nlshipp/openjtag-project/OpenJTAG/Docs/OPENJTAG Hardware User Manual_1.1.pdf

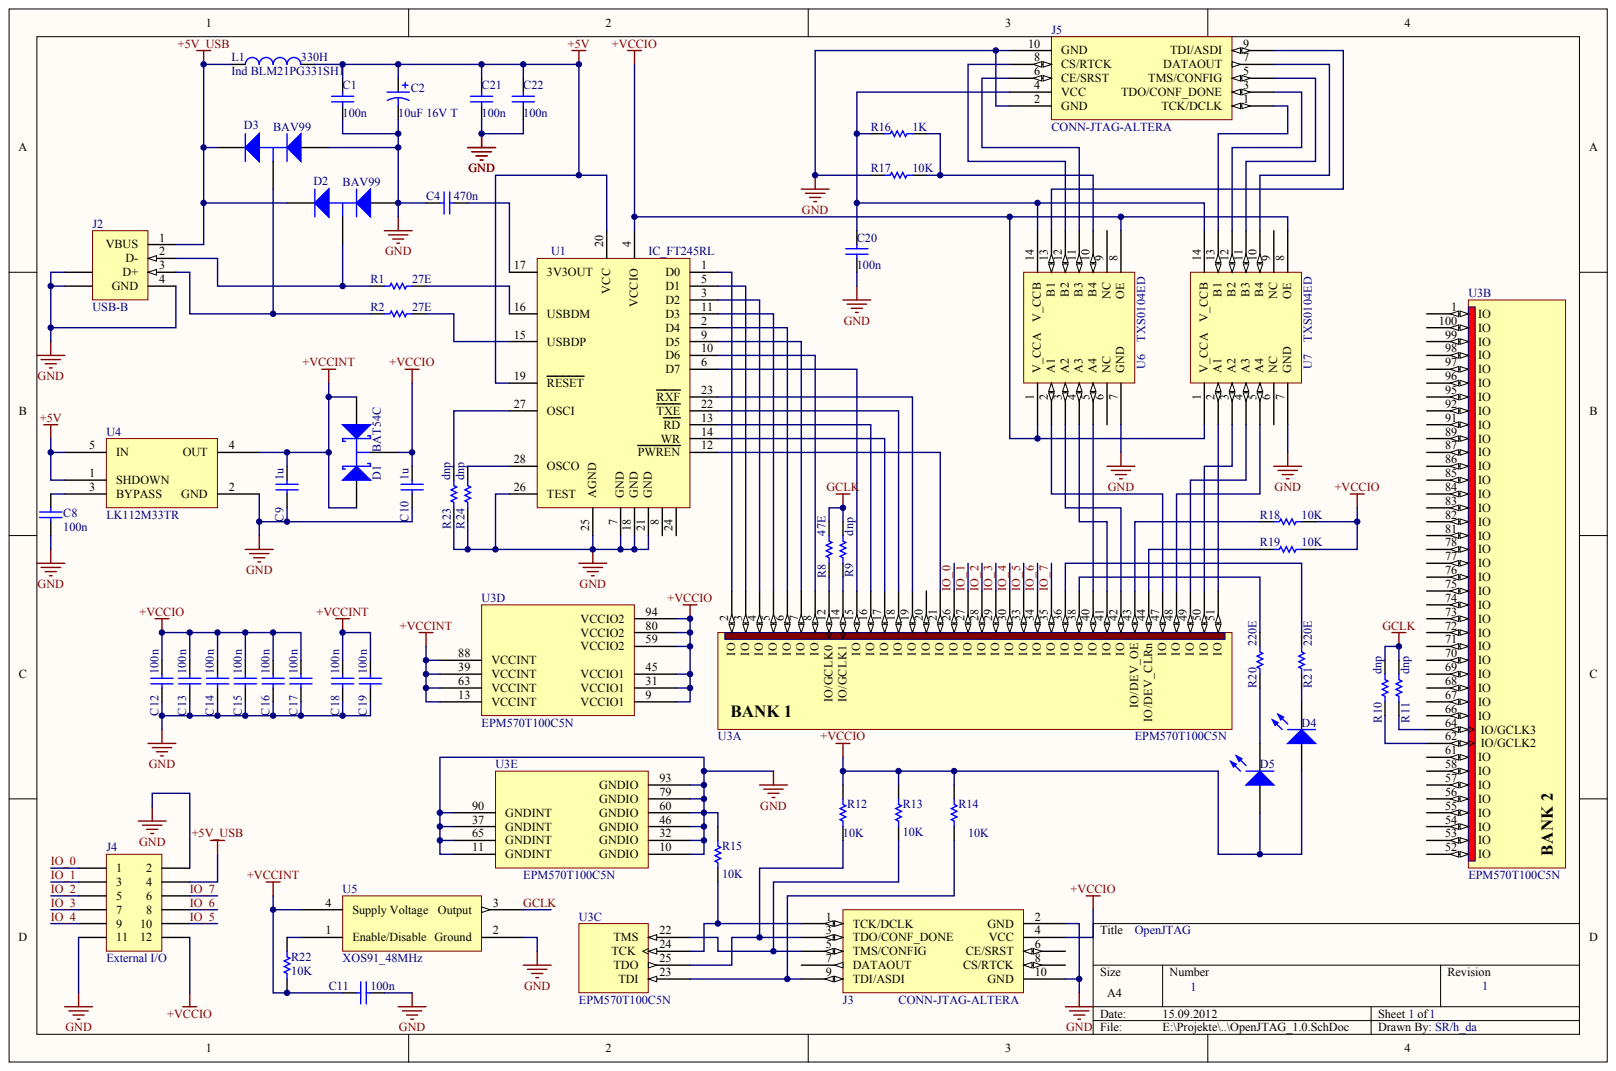
[picture p1: page 1]

GNDIO | 10 GNDINT 11 32 GNDIO 46 GNDIO 60

GNDINT 65
