nlshipp/openjtag-project/OpenJTAG/Docs/AK-OPENJTAG_V2.0.pdf

FPGA-POWER/CLOCK/JTAG | EXTERNAL JTAG/ETM CONNECTOR
20 B1 | 18 B2 | 17 B3 | 16 B4 | 15 B5 | 14 B6 | 13 B7 | 12 B8

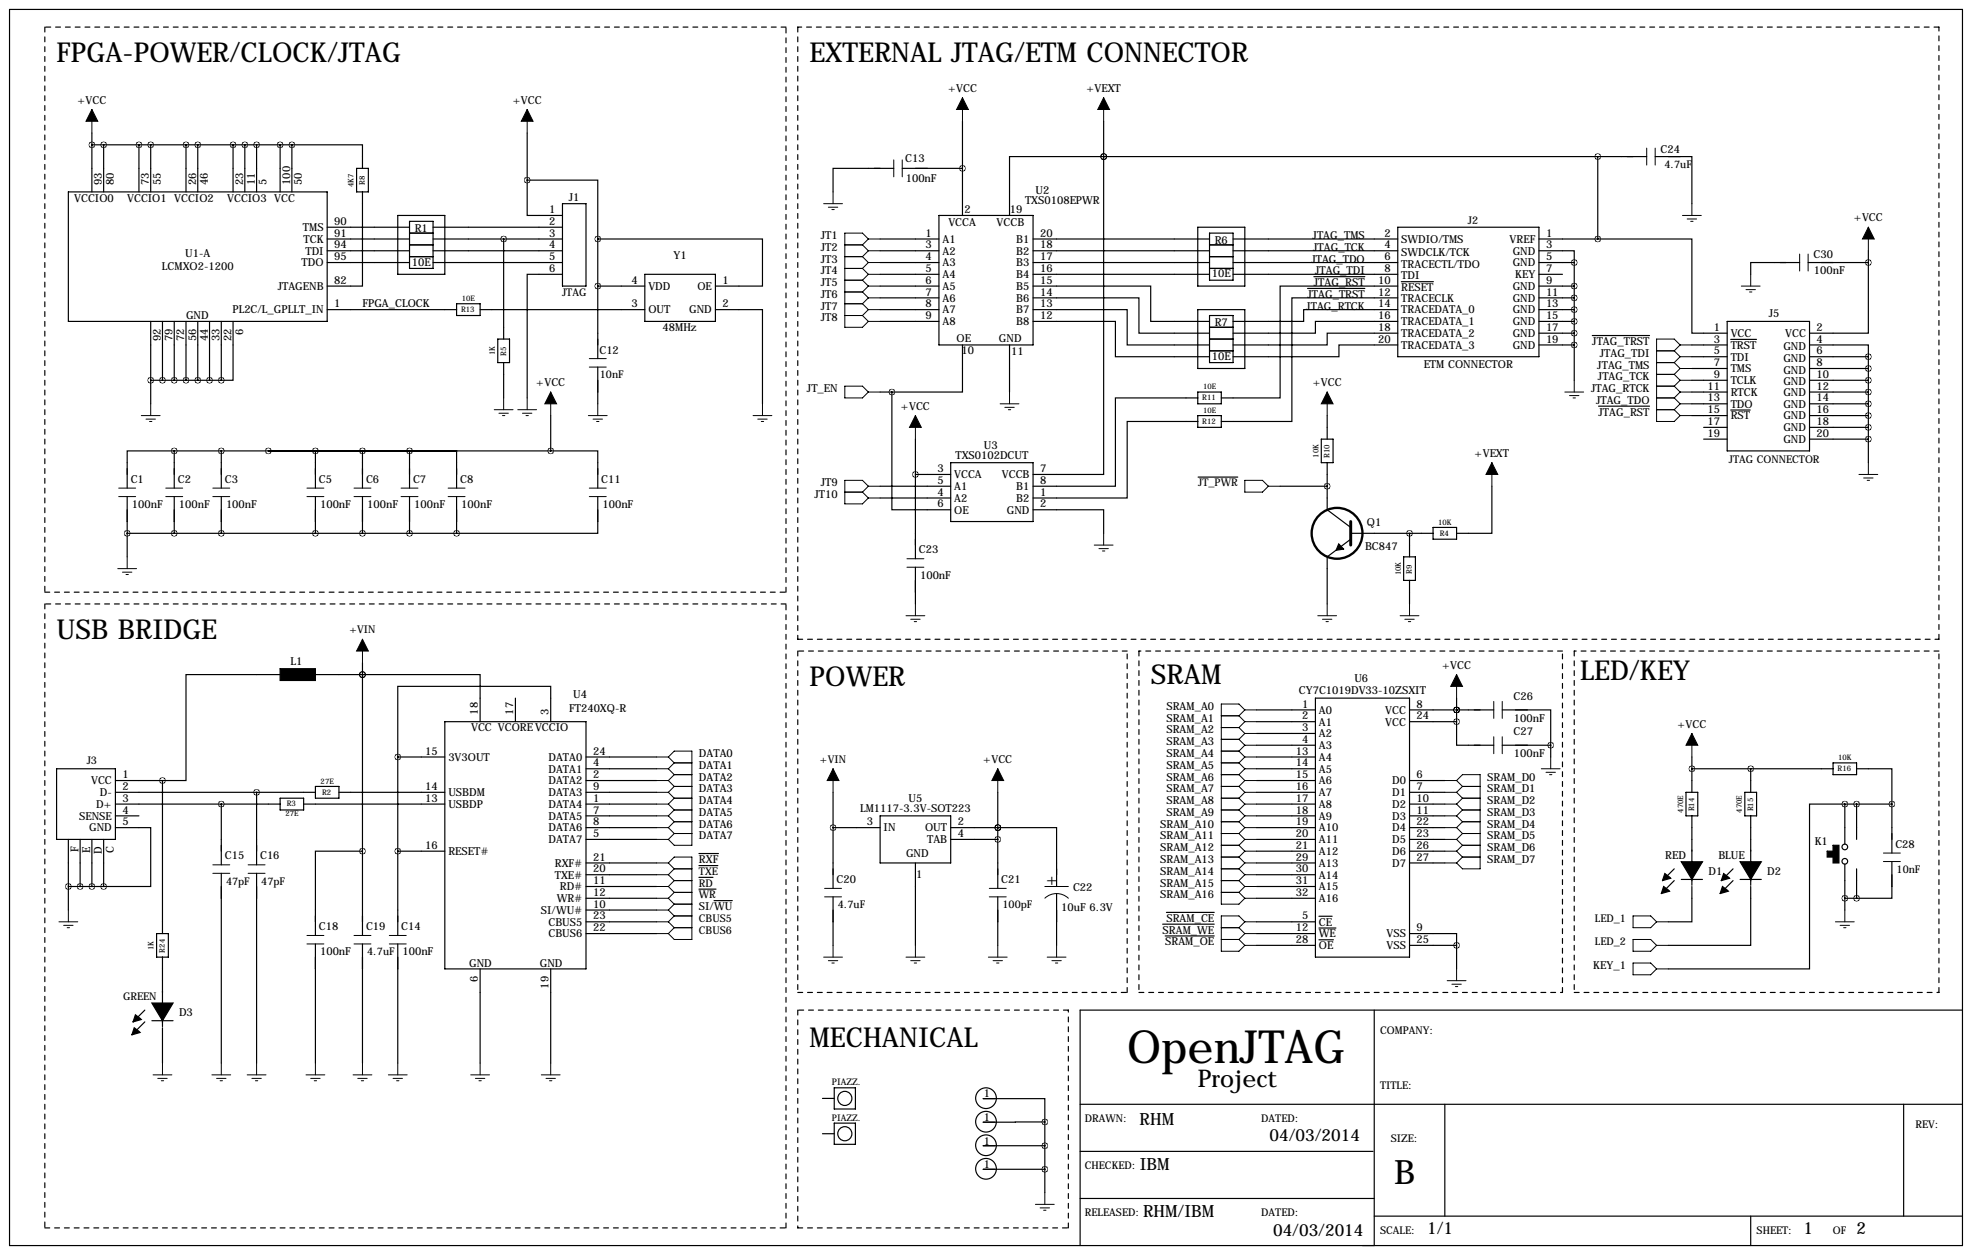
[picture p2: page 1]

# FLASH MEMORY FPGA

51 PR10D | 52 PR10C | 53 PR9D | 54 PR9C | 57 PR9B | 58 PR9A | 59 PR8D | 60 PR8C | 61 PR8A | 62 PR5D/PCLKC1_0 | 63 PR5C/PCLKT1_0 | 64 PR5B | 65 PR5A | 66 PR4D | 67 PR4C | 68 PR4B | 69 PR4A | 70 PR3B | 71 PR3A | 74 PR2B | 75 PR2A

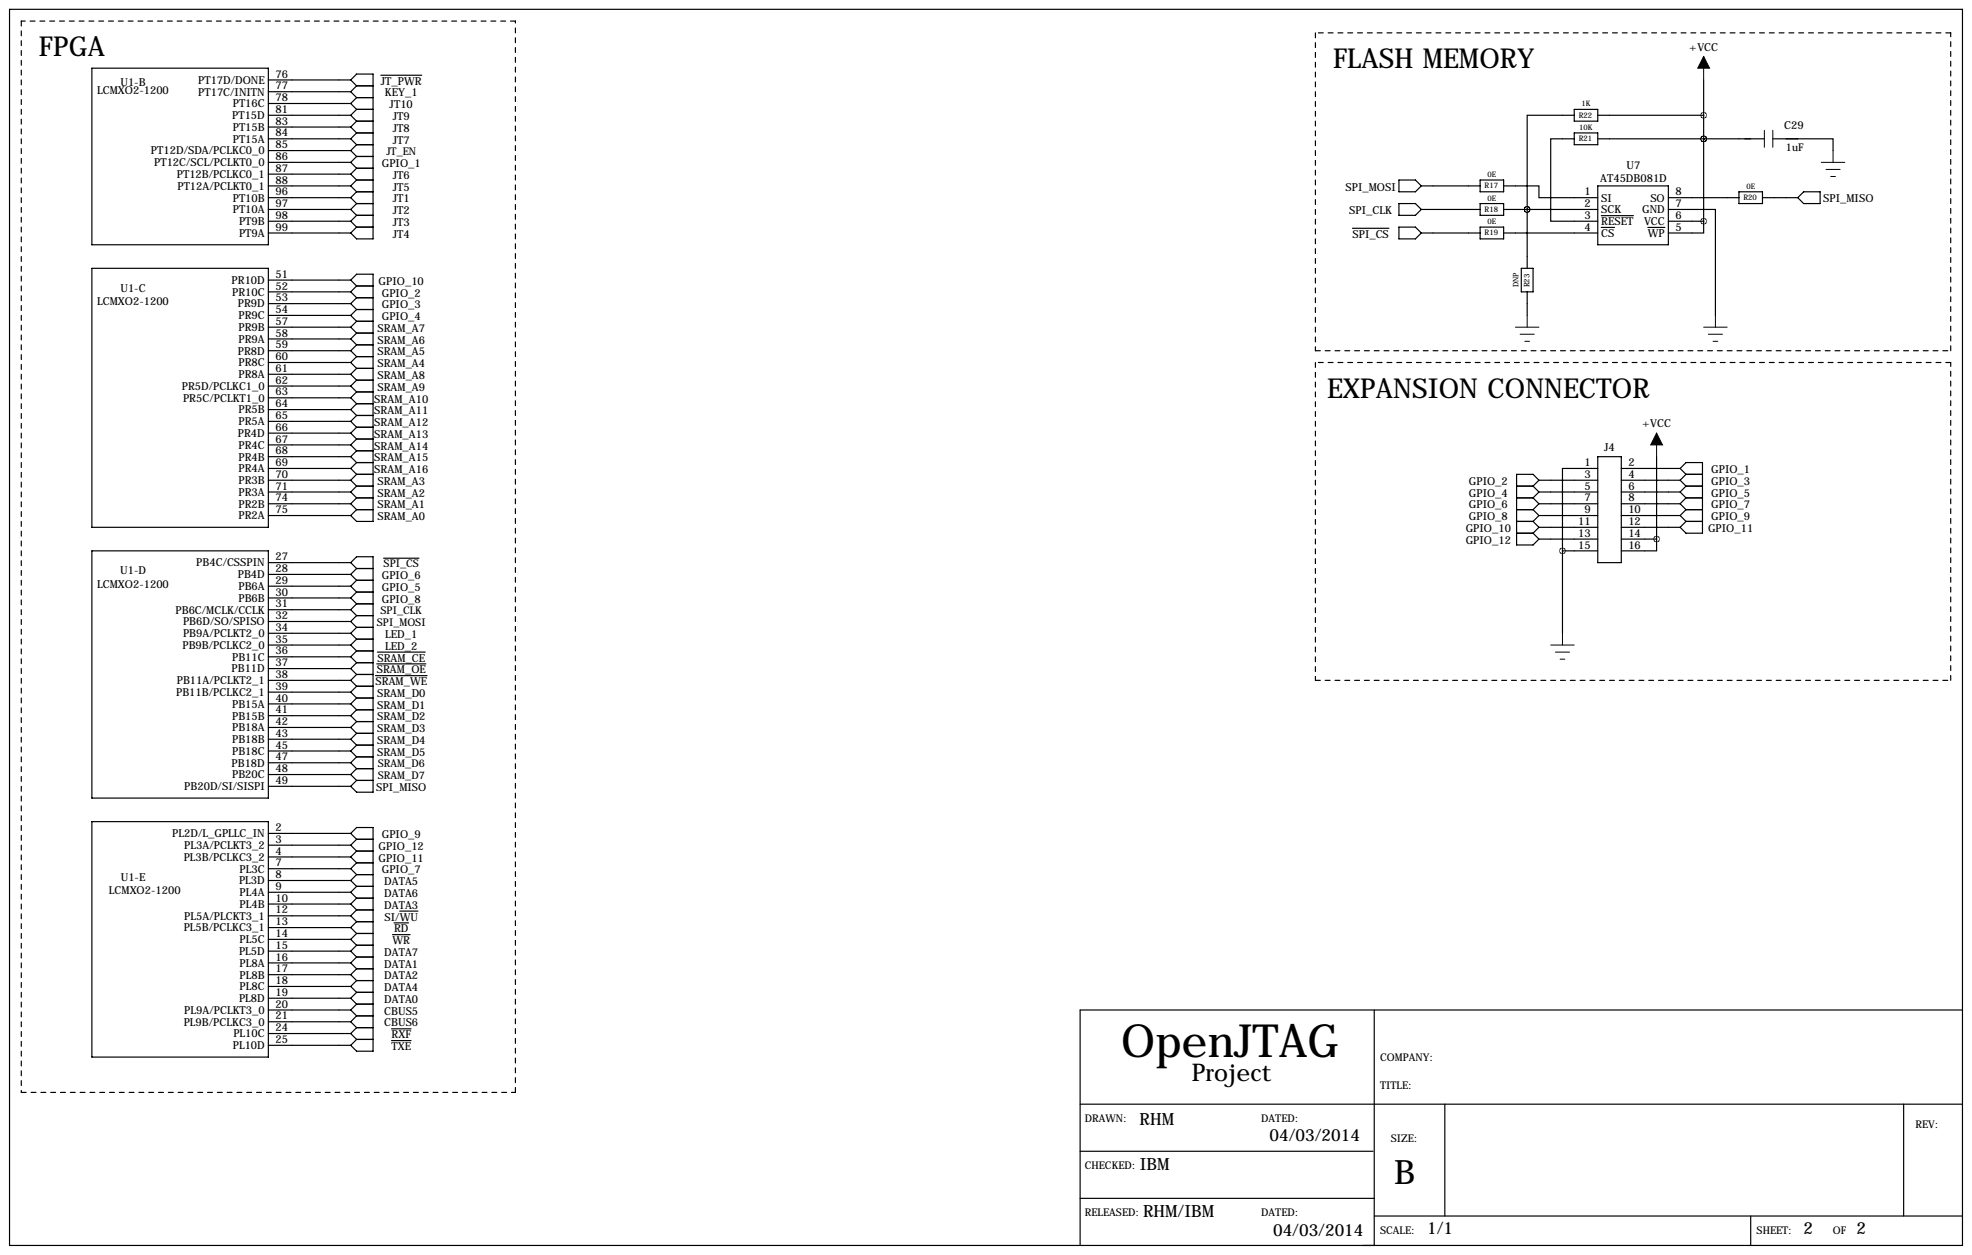
[picture p3: page 2]

EXPANSION CONNECTOR +VCC
