nlshipp/openjtag-project/(commit log)

2026-03-17 Add OpenJTAG2 board schematic
    Archive OpenJTAG2 board schematic pulled from
    https://web.archive.org/web/20141222014147/http:/www.openjtag.org/
    Used Lattice MachX02 device. Documented 2014/03/04.
2026-03-17 Add OpenJTAG schematic diagram 1.1
    Archive the OPENJTAG Hardware User Manual_1.1.pdf file that is a
    schematic for a device using the Altera Max II EPM570T100C5N
    FPGA and an FTDI FT245RL USB interface.
2026-03-18 Port to DE0-Nano and improve performance
    - Update toolchain to Quartus Prime 19.1 Lite Edition.
    - Change target device to Altera DE0-Nano with Cyclone IV E FPGA.
    - Generate SIWU# signal to tell FT232/245 to immediately send
    queued bytes to host after TAP is idle and RX queue is empty
    for four clock cycles.
    - Fix comment on rst signal of serializer. Should be connected to
    PWREN# or RSTOUT# signal on FT232/245 not #RESET.
    - Set rst signal to have weak pullup.
    - Speed up JTAG tap operations by removing unneeded delay states
    on FT245 read and write operations.
    - Rename TRST signal to SRST signal to reflect usage in OpenJTAG
    hardware implementations.
    - Count full TCK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
    [clock_mux.vhd, serializer.vhd]
2026-03-19 DE0 - Use 48MHz clock and fix some compilation warnings
    - Generate 48MHz PLL clock, not 96MHz. OpenJTAG set clock divisor
    sets desired main clock frequency. OpenJTAG protocol manual states
    TCK frequency is 1/2 main clock frequency.
    - Fix some generated warnings during compilation for clocks and
    latches.
    [clock_mux.vhd]
